tom1209-netizen/vit-tiny-accelerator/figure/block_diagram/attention_block.png

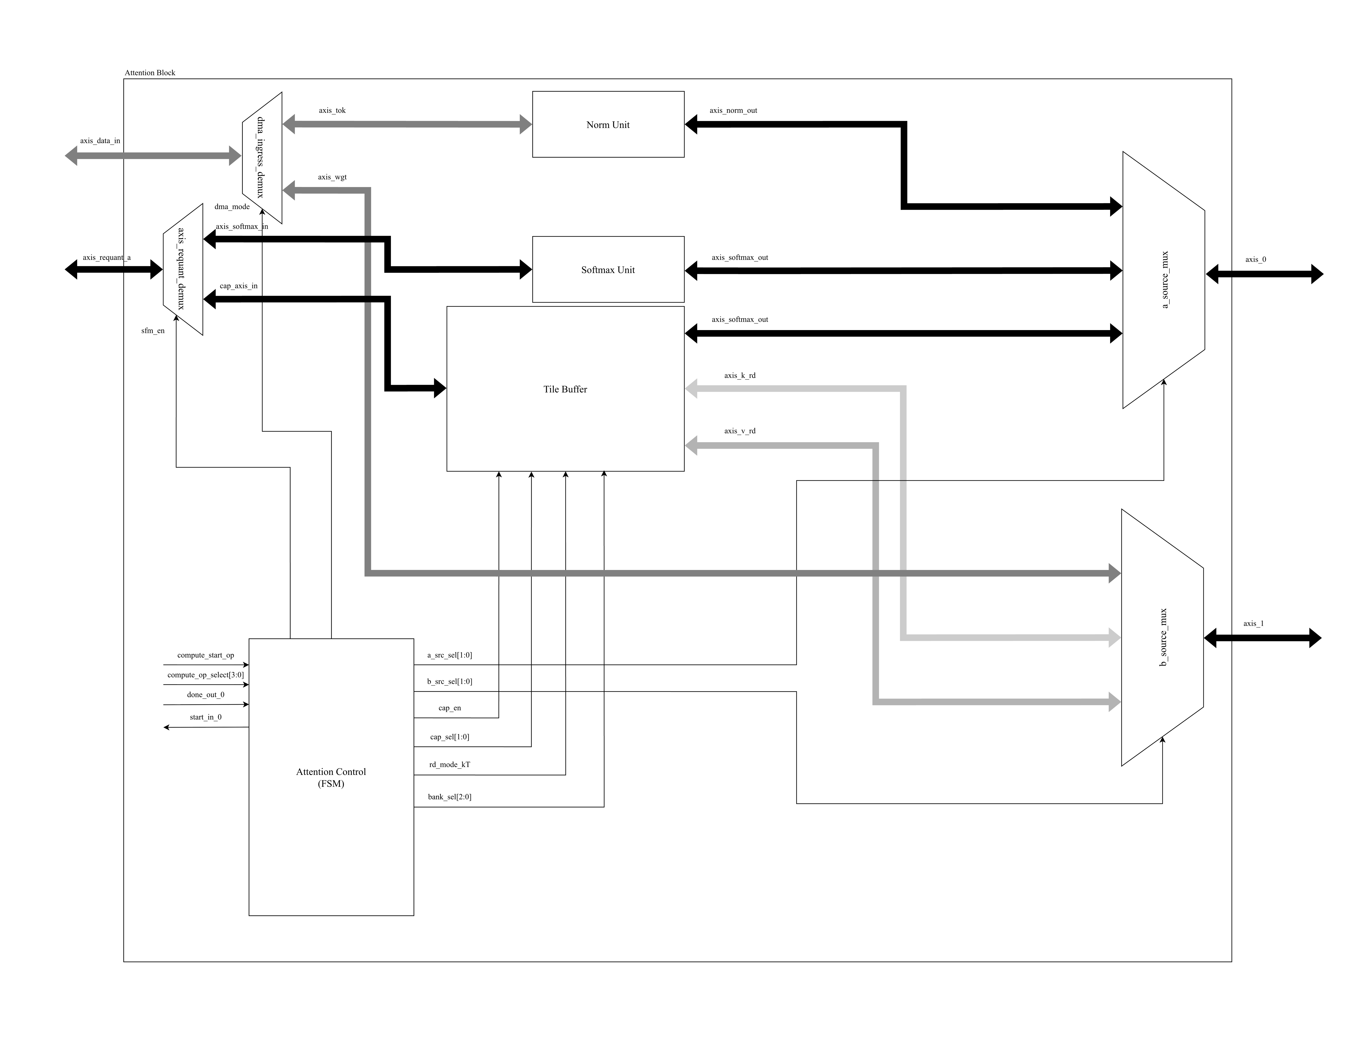
figure/block_diagram/attention_block.png
