tom1209-netizen/vit-tiny-accelerator/figure/block_diagram/ILA_VIO.png

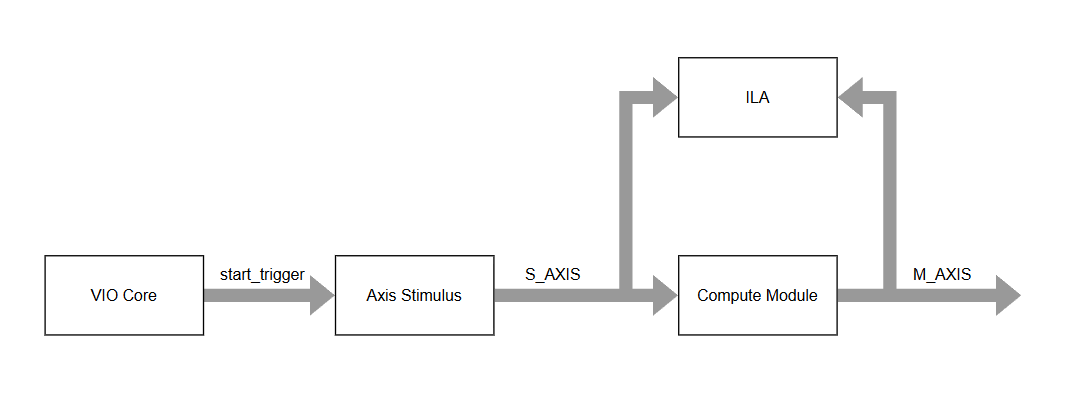
figure/block_diagram/ILA_VIO.png
