tom1209-netizen/vit-tiny-accelerator/figure/block_diagram/mlp_block.png

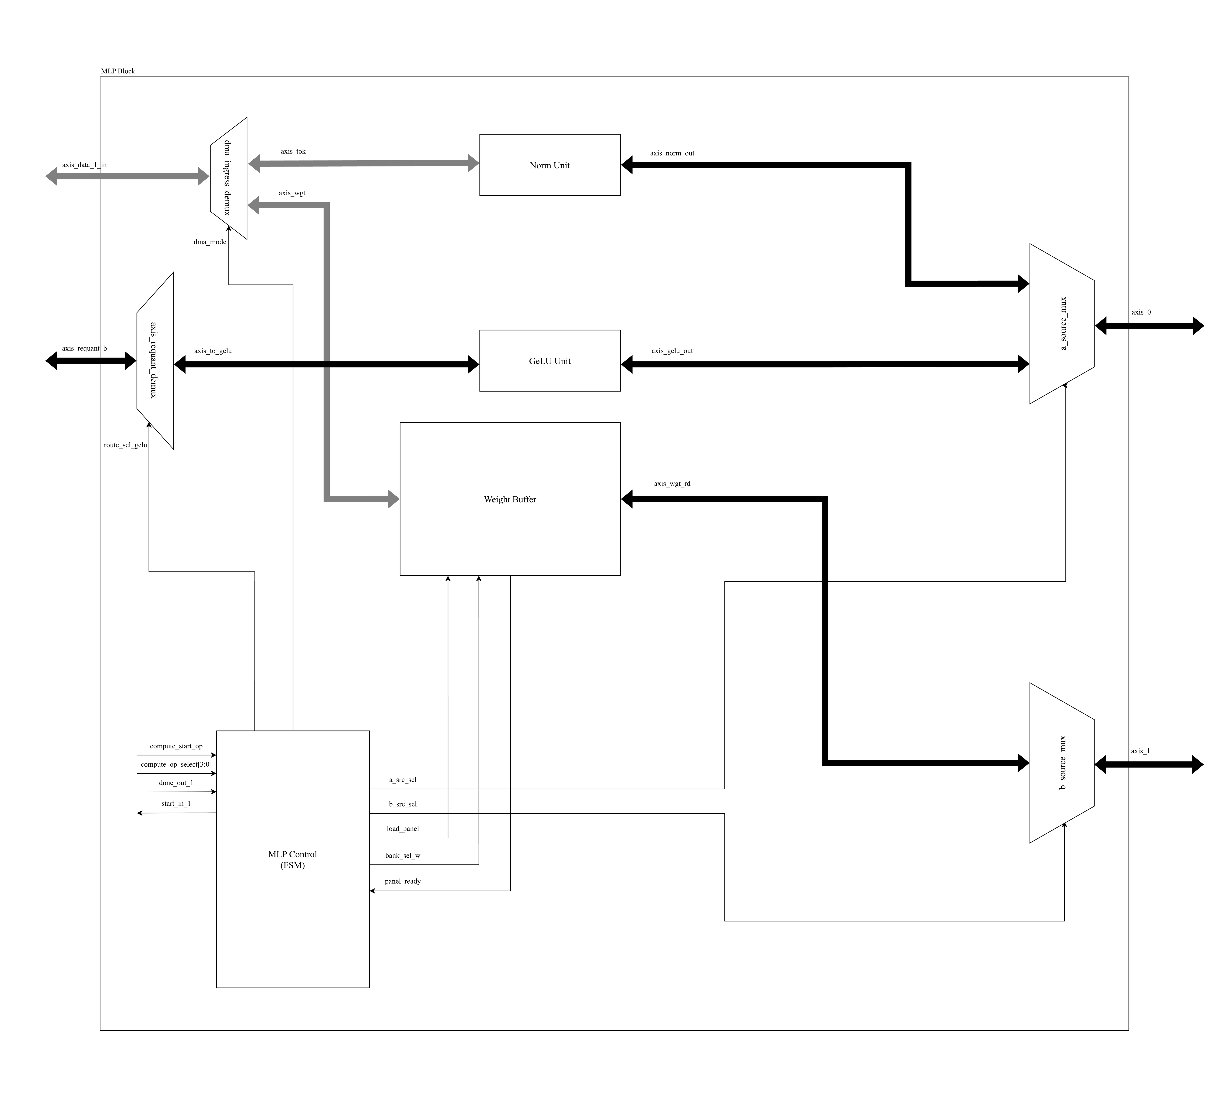
figure/block_diagram/mlp_block.png
