tom1209-netizen/vit-tiny-accelerator/fpga/ila/gemm/ila_waveform/gemm_ila_2.png

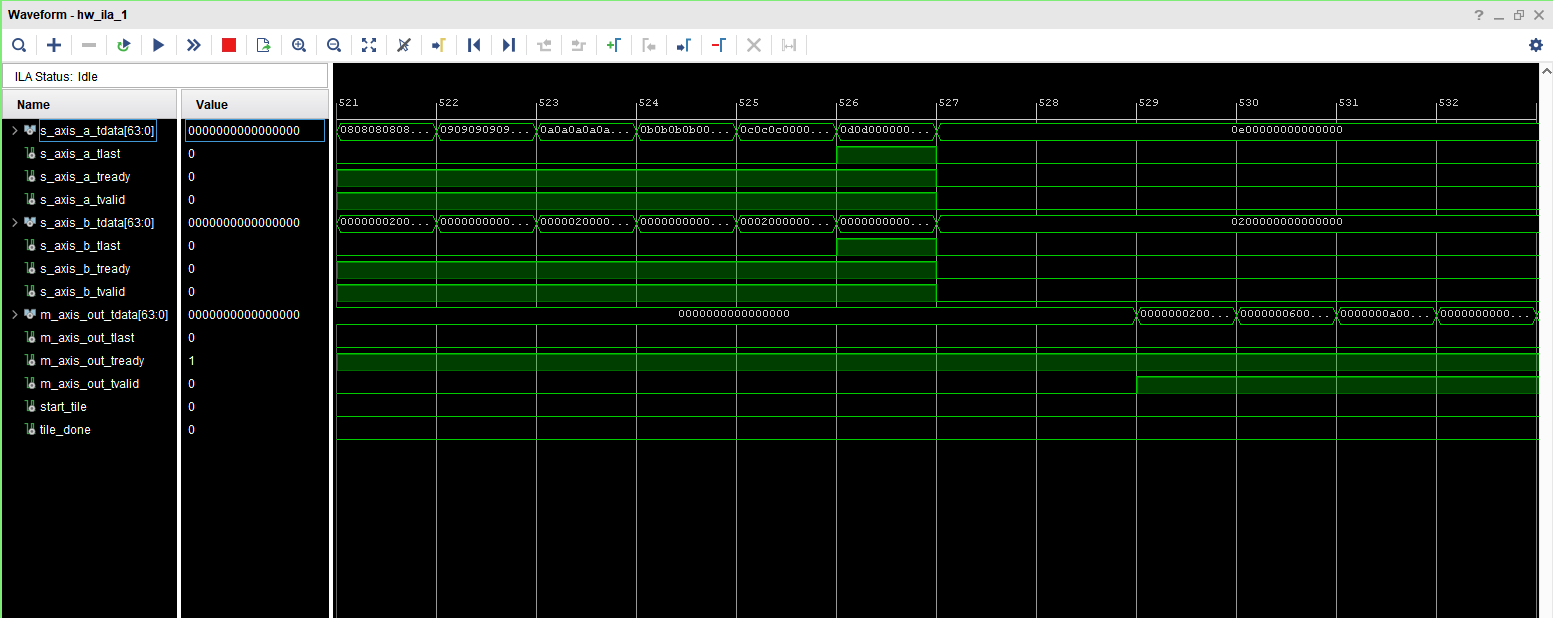
fpga/ila/gemm/ila_waveform/gemm_ila_2.png
