tom1209-netizen/vit-tiny-accelerator/fpga/ila/gemm/ila_waveform/gemm_ila_4.png

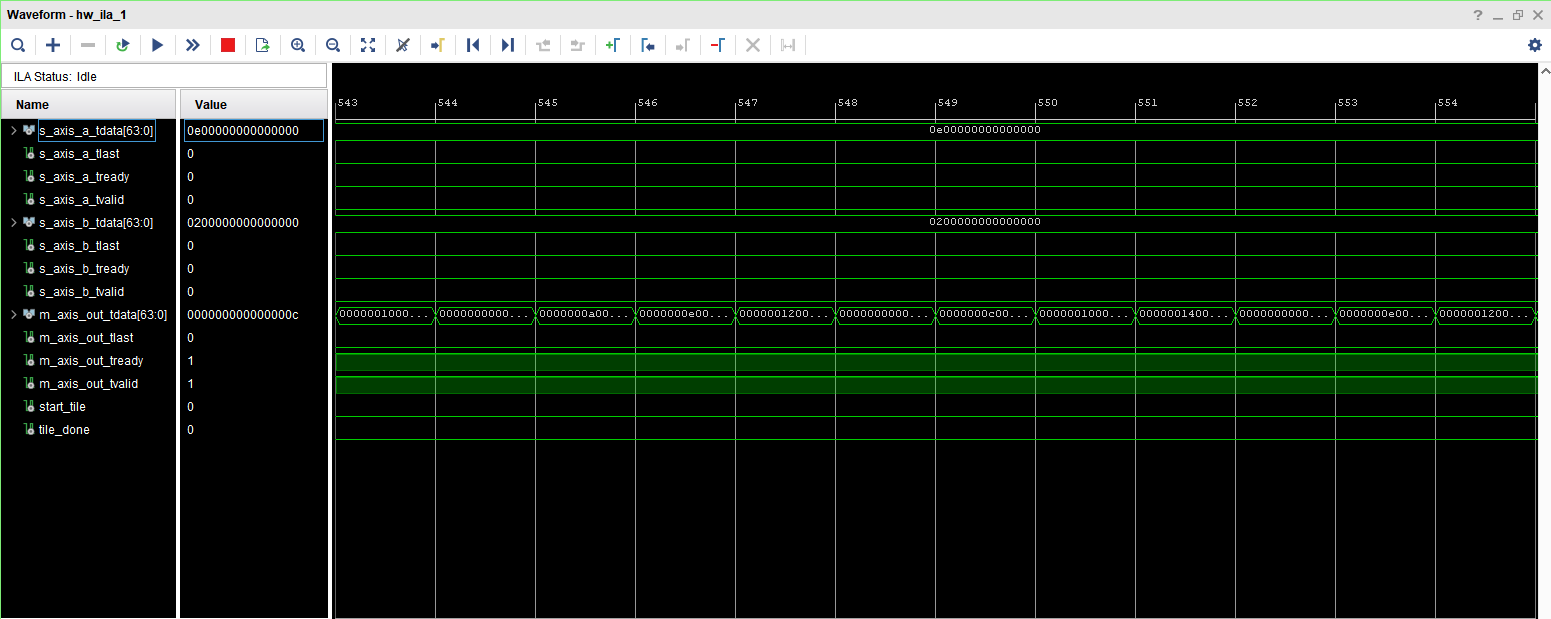
fpga/ila/gemm/ila_waveform/gemm_ila_4.png
