tom1209-netizen/vit-tiny-accelerator/fpga/ila/layer_norm/ila_waveform/layer_norm_ila_1.png

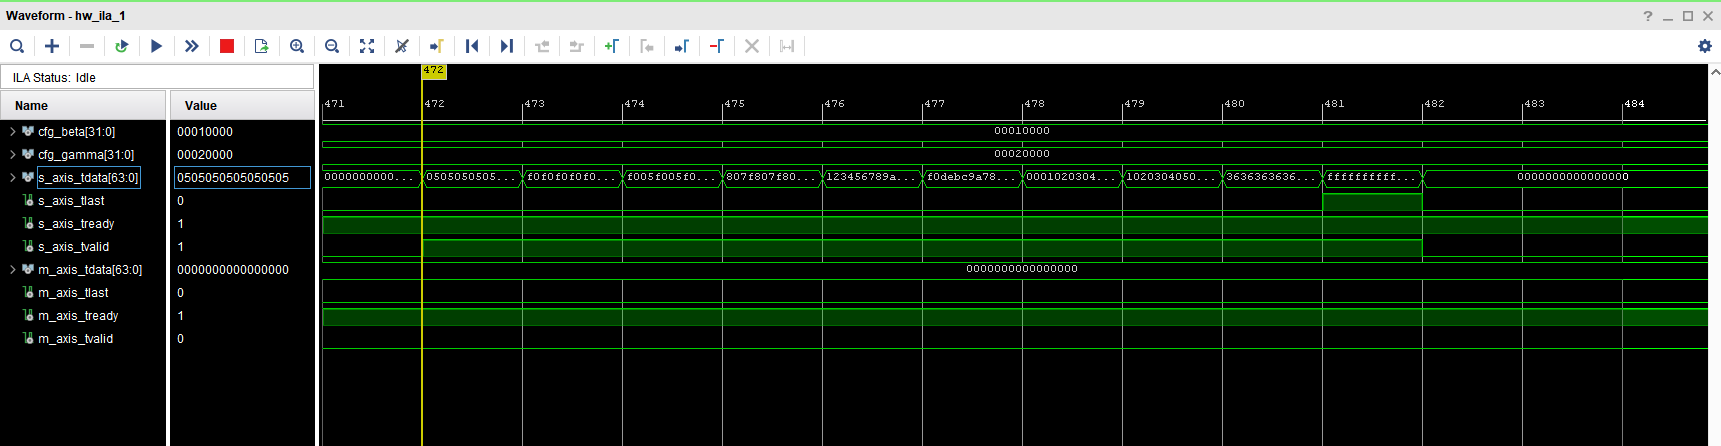
fpga/ila/layer_norm/ila_waveform/layer_norm_ila_1.png
