tom1209-netizen/vit-tiny-accelerator/fpga/ila/relu/ila_waveform/relu_ila.png

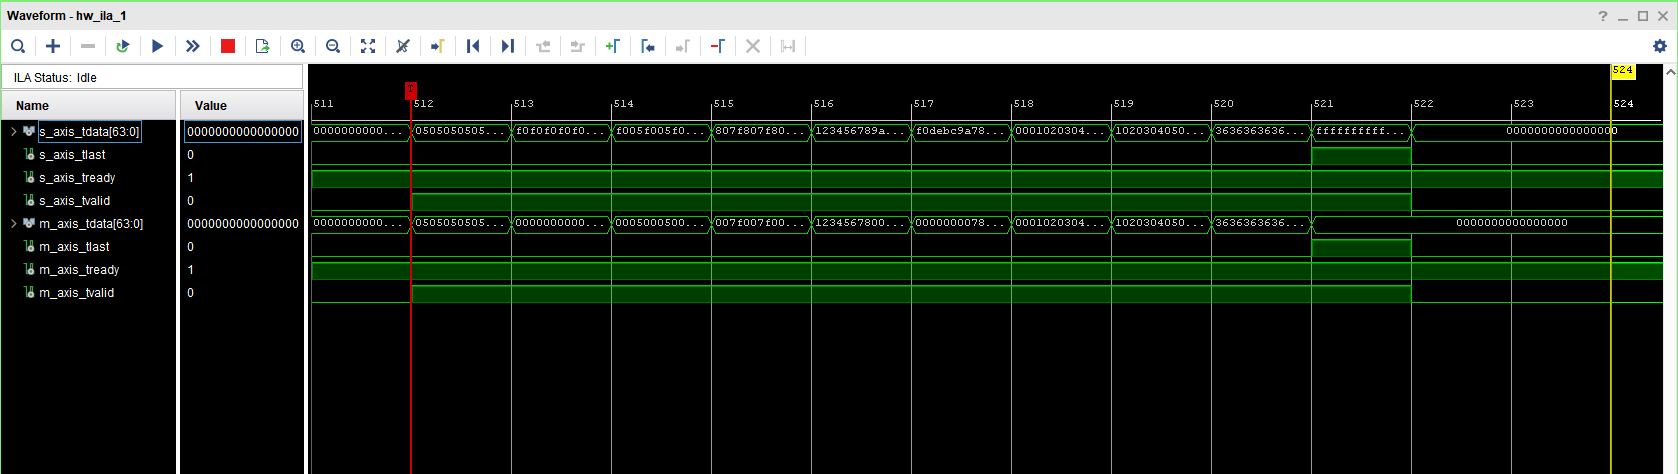
fpga/ila/relu/ila_waveform/relu_ila.png
