tom1209-netizen/vit-tiny-accelerator/fpga/ila/residual/ila_waveform/residual_add_ila.png

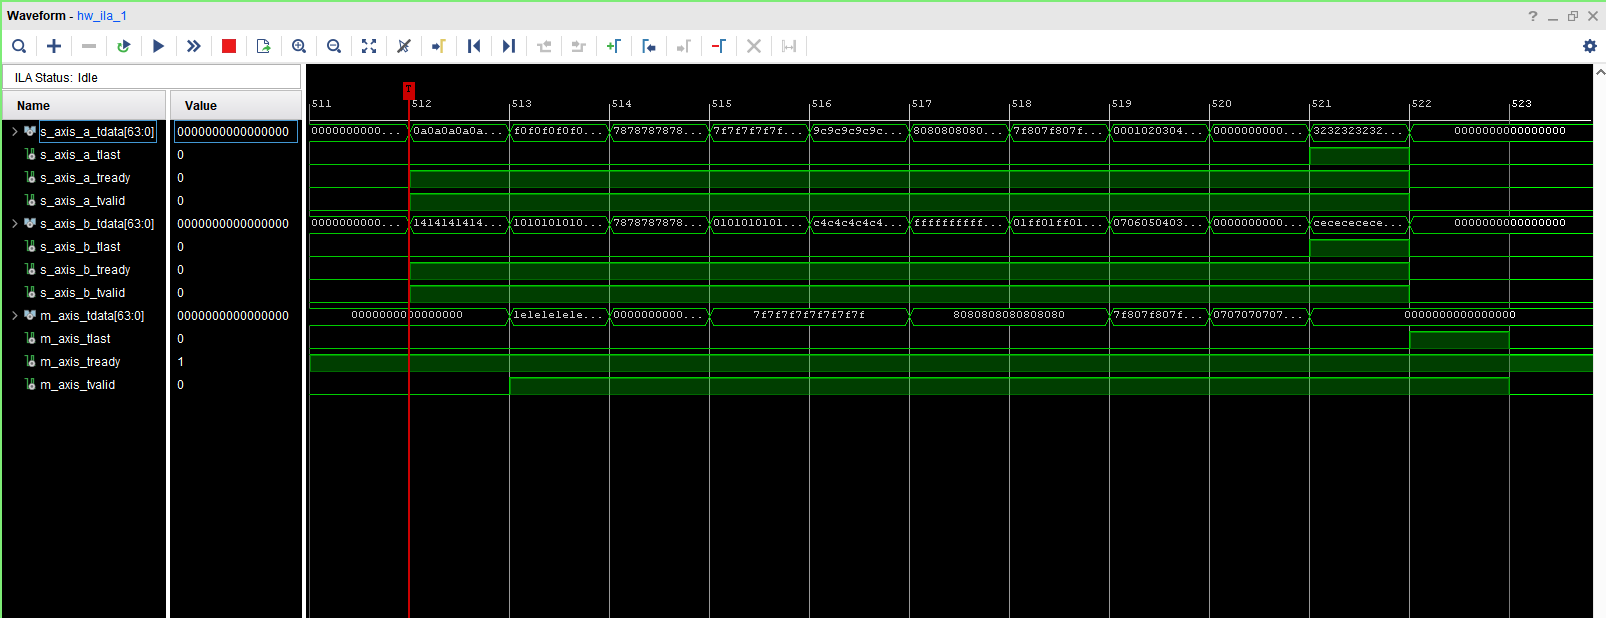
fpga/ila/residual/ila_waveform/residual_add_ila.png
