tom1209-netizen/vit-tiny-accelerator/models/figure/symmetric_example.png

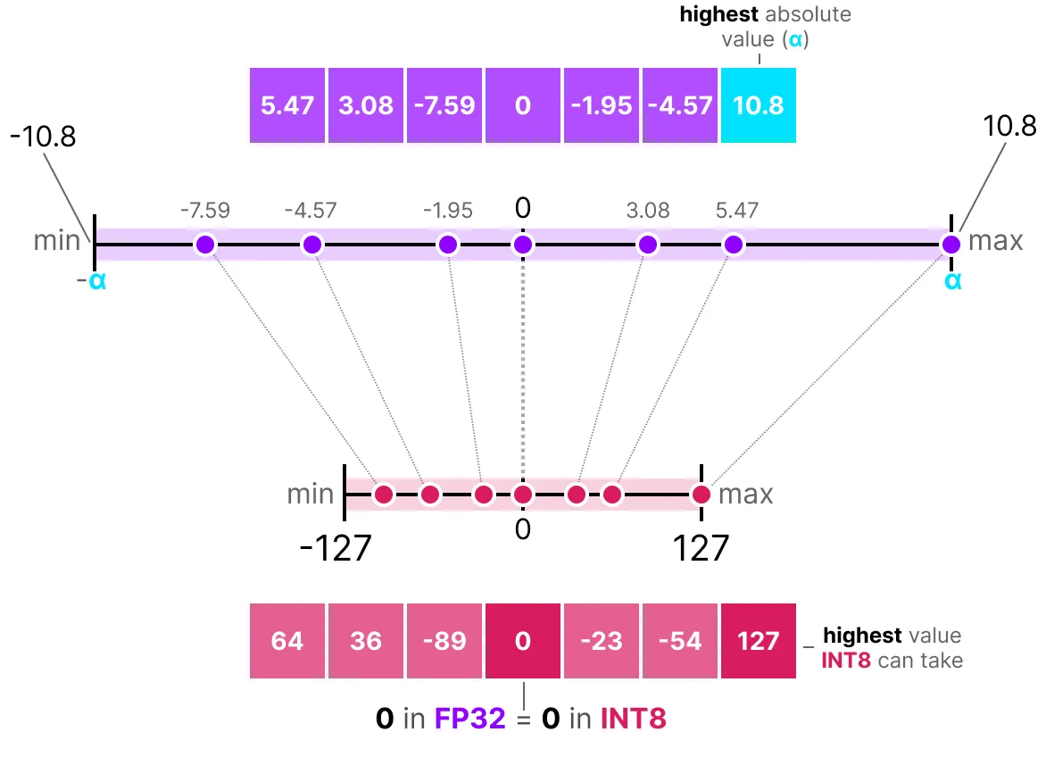
models/figure/symmetric_example.png
