tom1209-netizen/vit-tiny-accelerator/fpga/rtl/gemm/output_collector.v

module output_collector #(
    parameter ACC_WIDTH       = 32,
    parameter ARRAY_SIZE      = 8,
    parameter AXIS_DATA_WIDTH = 64,
    parameter VALUES_PER_BEAT = 2    // 64 bits / 32 bits = 2 INT32s
) (
    input wire clk,
    input wire rst_n,

    // Flattened input from systolic array (64 signals)
    input wire signed [ACC_WIDTH-1:0] acc_in_0_0,
    input wire signed [ACC_WIDTH-1:0] acc_in_0_1,
    input wire signed [ACC_WIDTH-1:0] acc_in_0_2,
    input wire signed [ACC_WIDTH-1:0] acc_in_0_3,
    input wire signed [ACC_WIDTH-1:0] acc_in_0_4,
    input wire signed [ACC_WIDTH-1:0] acc_in_0_5,
    input wire signed [ACC_WIDTH-1:0] acc_in_0_6,
    input wire signed [ACC_WIDTH-1:0] acc_in_0_7,

    input wire signed [ACC_WIDTH-1:0] acc_in_1_0,
    input wire signed [ACC_WIDTH-1:0] acc_in_1_1,
    input wire signed [ACC_WIDTH-1:0] acc_in_1_2,
    input wire signed [ACC_WIDTH-1:0] acc_in_1_3,
    input wire signed [ACC_WIDTH-1:0] acc_in_1_4,
    input wire signed [ACC_WIDTH-1:0] acc_in_1_5,
    input wire signed [ACC_WIDTH-1:0] acc_in_1_6,
    input wire signed [ACC_WIDTH-1:0] acc_in_1_7,

    input wire signed [ACC_WIDTH-1:0] acc_in_2_0,
    input wire signed [ACC_WIDTH-1:0] acc_in_2_1,
    input wire signed [ACC_WIDTH-1:0] acc_in_2_2,
    input wire signed [ACC_WIDTH-1:0] acc_in_2_3,
    input wire signed [ACC_WIDTH-1:0] acc_in_2_4,
    input wire signed [ACC_WIDTH-1:0] acc_in_2_5,
    input wire signed [ACC_WIDTH-1:0] acc_in_2_6,
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
                    4'd4: cell_ready = acc_done_7_4;
                    4'd5: cell_ready = acc_done_7_5;
                    4'd6: cell_ready = acc_done_7_6;
                    4'd7: cell_ready = acc_done_7_7;
                    default: cell_ready = 1'b0;
                endcase
                default: cell_ready = 1'b0;
            endcase
        end
    endfunction

    function beat_ready;
        input [3:0] r;
        input [3:0] c;
        integer offset;
        begin
            beat_ready = 1'b1;
            for (offset = 0; offset < VALUES_PER_BEAT; offset = offset + 1) begin
                if (c + offset < ARRAY_SIZE) beat_ready = beat_ready & cell_ready(r, c + offset);
            end
        end
    endfunction

    // Stream state machine
    always @(posedge clk or negedge rst_n) begin
        if (!rst_n) begin
            m_axis_tdata  <= {AXIS_DATA_WIDTH{1'b0}};
            m_axis_tvalid <= 1'b0;
            m_axis_tlast  <= 1'b0;
            row_idx       <= 4'd0;
            col_idx       <= 4'd0;
            active        <= 1'b0;
            done          <= 1'b0;
            start_pending <= 1'b0;
        end else begin
            // Capture the start request in a register
            if (start_output) start_pending <= 1'b1;

            // The "Watermark Trigger":
            //    Only go active if we have a pending request AND PE(0,4) is finished.
            //    PE(0,4) is the halfway point. Waiting for it gives us a perfect safety buffer.
            // Without this, we risk starting to read out results before they are ready and add a 
            // stall in the output stream for the first row.
            if ((start_output || start_pending) && !active && acc_done_0_4) begin
                active        <= 1'b1;
                start_pending <= 1'b0;  // Clear the pending flag
                row_idx       <= 4'd0;
                col_idx       <= 4'd0;
                done          <= 1'b0;
            end

            if (active) begin
                // Issue next beat when either idle or accepted
                if (!m_axis_tvalid || m_axis_tready) begin
                    if (row_idx < ARRAY_SIZE && col_idx < ARRAY_SIZE) begin
                        if (beat_ready(row_idx, col_idx)) begin
                            // Pack VALUES_PER_BEAT accumulators into 64-bit stream
                            m_axis_tdata[31:0] <= get_acc(row_idx, col_idx);
                            if (col_idx + 1 < ARRAY_SIZE)
                                m_axis_tdata[63:32] <= get_acc(row_idx, col_idx + 1);
                            else m_axis_tdata[63:32] <= {ACC_WIDTH{1'b0}};

                            m_axis_tvalid <= 1'b1;

                            // TLAST on final beat
                            if (row_idx == ARRAY_SIZE-1 && col_idx + VALUES_PER_BEAT >= ARRAY_SIZE) begin
                                m_axis_tlast <= 1'b1;
                                done         <= 1'b1;
                                active       <= 1'b0;
                            end else begin
                                m_axis_tlast <= 1'b0;
                            end

                            // Advance indices by VALUES_PER_BEAT
                            if (col_idx + VALUES_PER_BEAT >= ARRAY_SIZE) begin
                                col_idx <= 4'd0;
                                row_idx <= row_idx + 4'd1;
                            end else begin
                                col_idx <= col_idx + VALUES_PER_BEAT;
                            end
                        end else begin
                            m_axis_tvalid <= 1'b0;
                            m_axis_tlast  <= 1'b0;
                        end
                    end else begin
                        m_axis_tvalid <= 1'b0;
                        m_axis_tlast  <= 1'b0;
                    end
                end
            end else begin
                m_axis_tvalid <= 1'b0;
                m_axis_tlast  <= 1'b0;
            end
        end
    end

endmodule
