tom1209-netizen/vit-tiny-accelerator/fpga/rtl/gemm/systolic_array.v

module systolic_array #(
    parameter DATA_WIDTH = 8,
    parameter ACC_WIDTH  = 32,
    parameter ARRAY_SIZE = 8
) (
    input wire clk,
    input wire rst_n,

    // Flattened A inputs (8 rows)
    input wire signed [DATA_WIDTH-1:0] a_in_0,
    input wire signed [DATA_WIDTH-1:0] a_in_1,
    input wire signed [DATA_WIDTH-1:0] a_in_2,
    input wire signed [DATA_WIDTH-1:0] a_in_3,
    input wire signed [DATA_WIDTH-1:0] a_in_4,
    input wire signed [DATA_WIDTH-1:0] a_in_5,
    input wire signed [DATA_WIDTH-1:0] a_in_6,
    input wire signed [DATA_WIDTH-1:0] a_in_7,

    input wire a_valid_in_0,
    input wire a_valid_in_1,
    input wire a_valid_in_2,
    input wire a_valid_in_3,
    input wire a_valid_in_4,
    input wire a_valid_in_5,
    input wire a_valid_in_6,
    input wire a_valid_in_7,

    // Flattened B inputs (8 columns)
    input wire signed [DATA_WIDTH-1:0] b_in_0,
    input wire signed [DATA_WIDTH-1:0] b_in_1,
    input wire signed [DATA_WIDTH-1:0] b_in_2,
    input wire signed [DATA_WIDTH-1:0] b_in_3,
    input wire signed [DATA_WIDTH-1:0] b_in_4,
    input wire signed [DATA_WIDTH-1:0] b_in_5,
    input wire signed [DATA_WIDTH-1:0] b_in_6,
    input wire signed [DATA_WIDTH-1:0] b_in_7,

    input wire b_valid_in_0,
    input wire b_valid_in_1,
    input wire b_valid_in_2,
    input wire b_valid_in_3,
    input wire b_valid_in_4,
    input wire b_valid_in_5,
    input wire b_valid_in_6,
    input wire b_valid_in_7,

    input wire clear_acc,

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
    assign acc_done_6_2 = acc_done_wire[6][2];
    assign acc_done_6_3 = acc_done_wire[6][3];
    assign acc_done_6_4 = acc_done_wire[6][4];
    assign acc_done_6_5 = acc_done_wire[6][5];
    assign acc_done_6_6 = acc_done_wire[6][6];
    assign acc_done_6_7 = acc_done_wire[6][7];

    assign acc_done_7_0 = acc_done_wire[7][0];
    assign acc_done_7_1 = acc_done_wire[7][1];
    assign acc_done_7_2 = acc_done_wire[7][2];
    assign acc_done_7_3 = acc_done_wire[7][3];
    assign acc_done_7_4 = acc_done_wire[7][4];
    assign acc_done_7_5 = acc_done_wire[7][5];
    assign acc_done_7_6 = acc_done_wire[7][6];
    assign acc_done_7_7 = acc_done_wire[7][7];

    // Generate 64 PEs (8x8 grid)
    genvar row, col;
    generate
        for (row = 0; row < ARRAY_SIZE; row = row + 1) begin : pe_row
            for (col = 0; col < ARRAY_SIZE; col = col + 1) begin : pe_col

                processing_element #(
                    .DATA_WIDTH(DATA_WIDTH),
                    .ACC_WIDTH (ACC_WIDTH),
                    .ARRAY_SIZE(ARRAY_SIZE)
                ) pe_inst (
                    .clk  (clk),
                    .rst_n(rst_n),

                    // 'A' path connections
                    .a_in(a_wire[row][col]),
                    .a_valid_in(a_valid_wire[row][col]),
                    .a_out(a_wire[row][col+1]),
                    .a_valid_out(a_valid_wire[row][col+1]),

                    // 'B' path connections
                    .b_in(b_wire[row][col]),
                    .b_valid_in(b_valid_wire[row][col]),
                    .b_out(b_wire[row+1][col]),
                    .b_valid_out(b_valid_wire[row+1][col]),

                    .clear_acc(clear_acc),
                    .acc_out  (acc_wire[row][col]),
                    .acc_done (acc_done_wire[row][col])
                );

                assign mac_active[row][col] = a_valid_wire[row][col] && b_valid_wire[row][col];

            end
        end
    endgenerate

    // Collapse all PE valid overlaps to a single activity indicator so top-level
    // logic knows when MACs are still in flight.
    integer r, c;
    reg array_active_r;
    always @(*) begin
        array_active_r = 1'b0;
        for (r = 0; r < ARRAY_SIZE; r = r + 1) begin
            for (c = 0; c < ARRAY_SIZE; c = c + 1) begin
                array_active_r = array_active_r | mac_active[r][c];
            end
        end
    end

    assign array_active = array_active_r;

endmodule
