tom1209-netizen/vit-tiny-accelerator/(commit log)

2025-11-01 add AXI DMA IP in README.md
2025-11-01 Feat: add signal table for axi dma shim
2025-11-01 Feat: add signal table for axi dma ip
2025-11-06 feat: update with scatter gather mode for axi dma
2025-11-11 Feat: add build script that build and program board
2025-11-29 Feat: add shape trace documnet
2025-12-05 feat: add layernorm and its tb (currently 112MHz)
2025-12-15 Fix: funny error in GEMM core waveform
    [output_collector.v, tb_gemm_core_top.v]
2025-12-15 update: direct register mode for axi dma
2025-12-15 Fix: minor fix to softmax behaviour
    [softmax_unit.v, tb_softmax_unit.v]
2025-12-16 update: add counter for layernorm with some predefined packet lens to do the 1/N
2025-12-17 feat: 64 bits dma stream with padding (ARGB), 32 bits vdma stream for HDMI
2026-01-02 Feat: Improve resource usage of depthwise conv unit
    - Use SRL32E for delay taps in depthwise conv unit
    - Minor waveform updates for depthwise conv steady state processing
    - Fix Vivado library compilation in simulation Makefile
    [depthwise_conv_unit.v, kernel_buffer.v, mac_unit.v, srl_delay_tap.v]
2026-01-13 Feat: update structure for benchmarking with AXI Timer
